lgray14/Ocean-wave-energy-device/images/2signal.png

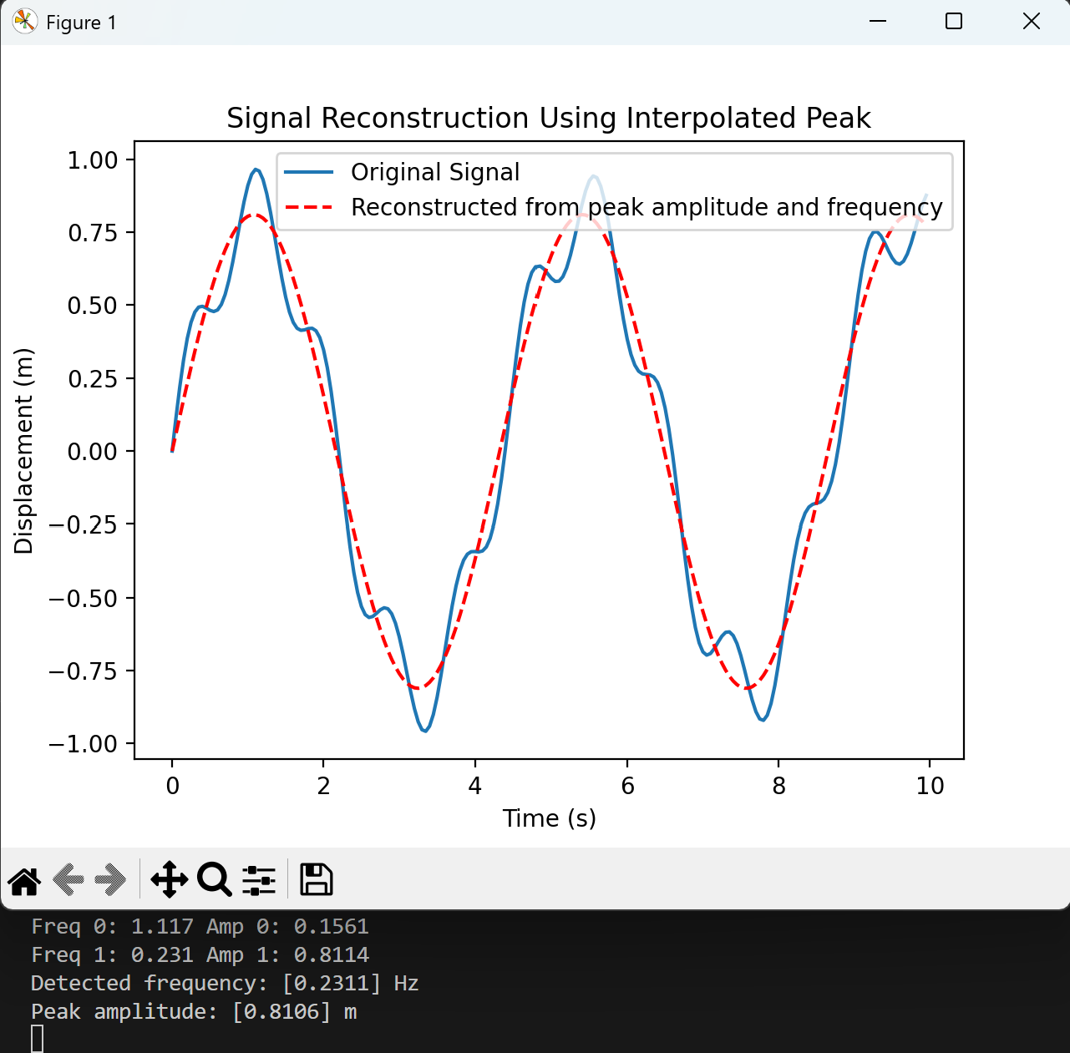
images/2signal.png
