lgray14/Ocean-wave-energy-device/code/arduino/ina_hall_sensor_test.ino

#include <Wire.h>
#include <Adafruit_INA219.h>
 
Adafruit_INA219 ina219;
 
void setup(void)
{
  Serial.begin(115200);
  while (!Serial) 
  {
    delay(1);
  }
 
  // Initialize the INA219.
  if (! ina219.begin())
  {
    Serial.println("Failed to find INA219 chip");
    while (1) 
    {
      delay(10);
    }
  }
  // To use a slightly lower 32V, 1A range (higher precision on amps):
  //ina219.setCalibration_32V_1A();
  // Or to use a lower 16V, 400mA range, call:
  //ina219.setCalibration_16V_400mA();
 
  Serial.println("Measuring voltage, current, and power with INA219 ...");
}
 
void loop(void)
{
  float shuntvoltage = 0;
  float busvoltage = 0;
  float current_mA = 0;
  float loadvoltage = 0;
  // float power_mW = 0;
 
  shuntvoltage = ina219.getShuntVoltage_mV();
  busvoltage = ina219.getBusVoltage_V();
  current_mA = ina219.getCurrent_mA();
  // power_mW = ina219.getPower_mW();
  loadvoltage = busvoltage + (shuntvoltage / 1000);
 
  Serial.print("Bus Voltage:   "); Serial.print(busvoltage); Serial.println(" V");
  Serial.print("Shunt Voltage: "); Serial.print(shuntvoltage); Serial.println(" mV");
  Serial.print("Load Voltage:  "); Serial.print(loadvoltage); Serial.println(" V");
  Serial.print("Current:       "); Serial.print(current_mA); Serial.println(" mA");
  // Serial.print("Power:         "); Serial.print(power_mW); Serial.println(" mW");
  // Serial.println("");
 
  delay(10000);
}
