lgray14/Ocean-wave-energy-device/(commit log)

2025-08-20 add sinusoid and sensor wiring imgs
2025-08-20 add section on tof sensor
2025-08-20 add section on ina sensor
2025-08-21 add section on filtering
